ole00/genesis_wifi_flash_cart_8mbit/img/prototype_r1.jpg

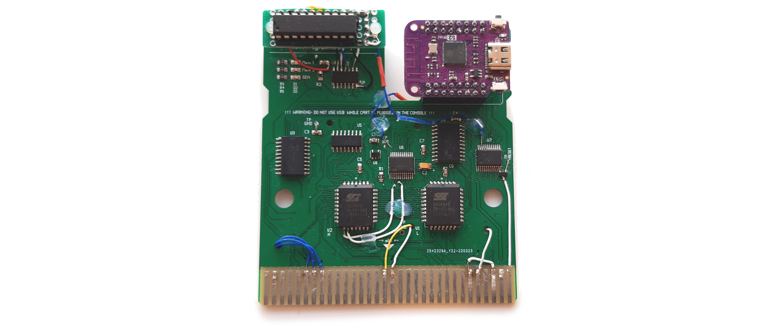
img/prototype_r1.jpg
