ole00/genesis_wifi_flash_cart_8mbit/schematic.pdf

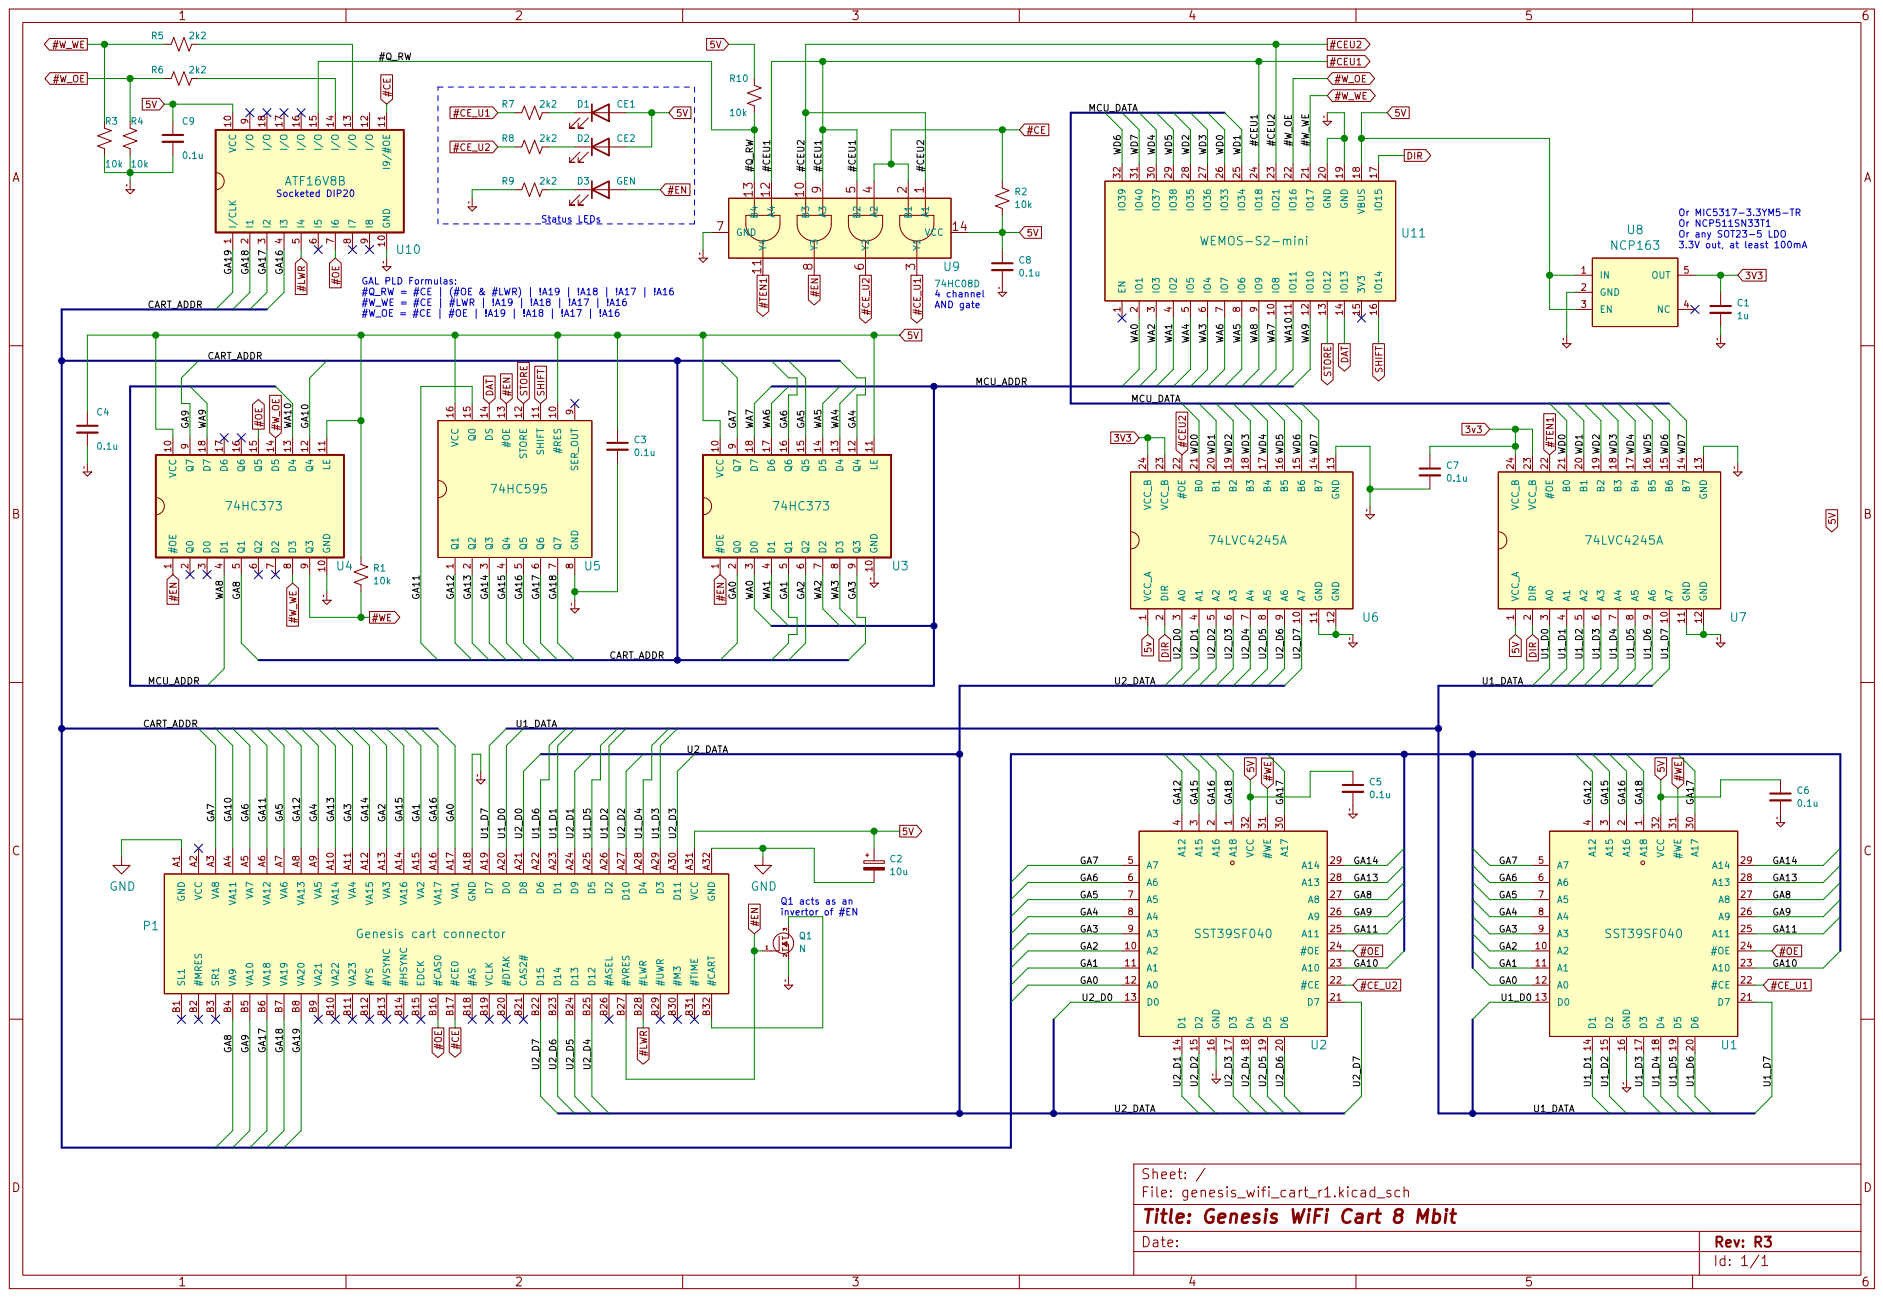
[picture p3: page 1]

9 U10 ATF16V8B
#W_OE = #CE | #OE | !A19 | !A18 | !A17 | !A16 Status LEDs Socketed DIP20

Or MIC5317-3.3YM5-TR Or NCP511SN33T1 Or any SOT23-5 LDO

3.3V out, at least 100mA GAL PLD Formulas: #Q_RW = #CE | (#OE & #LWR) | !A19 | !A18 | !A17 | !A16

1 #RES 10 SHIFT 11 STORE 12 #OE 13 DS 14 Q0 15 VCC 16 Q2

1 A7 10 GND 11 GND 12 GND 13 B7 14 B6 15 B5 16 B4 17 B3 18 B2 19 DIR

Id: 1/1 Title: Genesis WiFi Cart 8 Mbit
