ole00/genesis_wifi_flash_cart_8mbit/(list of files, drawings)

Other design files:
flash_cart_8mbit_sop.pcb
