ole00/genesis_wifi_flash_cart_8mbit/(commit log)

2022-05-14 initial commit - WORK IN PROGRESS
    [flash_cart_8mbit_sop.pcb]
2022-05-14 updated prototype image
2022-05-16 pcb: increased the width of the top frame above the antenna cut-out
    The production returned the previous design and asked of at least
    4mm width in order to produce the pcb reliably.
    [flash_cart_8mbit_sop.pcb]
2022-05-20 schematic now contains text symbols which can be searched
2022-05-20 added BOM
2022-06-03 added gerbers - rev 3
2022-06-03 added image of the pcb rev 3
2022-06-03 BOM: added LEDS and U10
    - added 0805 status LEDs D1 D2 D3
    - added ATF16V8B GAL IC U10
2022-06-05 BOM: added Q1
